domalouf/DreamCatcher/README.md

# DreamCatcher
 A react native mobile app for the DreamCatcher sleep mask

- `DreamCatcherAppNew/` - the app
- `arduino/` - mask firmware
- `hardware/` - PCB design for the mask ([details](hardware/README.md))
