domalouf/DreamCatcher/hardware/dreamcatcher-eye-sensor/drc-report.txt

** Drc report for  **
** Created on 2026-11-14 04:47:26 **

** Found 0 DRC violations **

** Found 0 unconnected pads **

** Found 0 Footprint errors **

** End of Report **
