domalouf/DreamCatcher/DreamCatcherAppNew/src/images/landscape.jpg

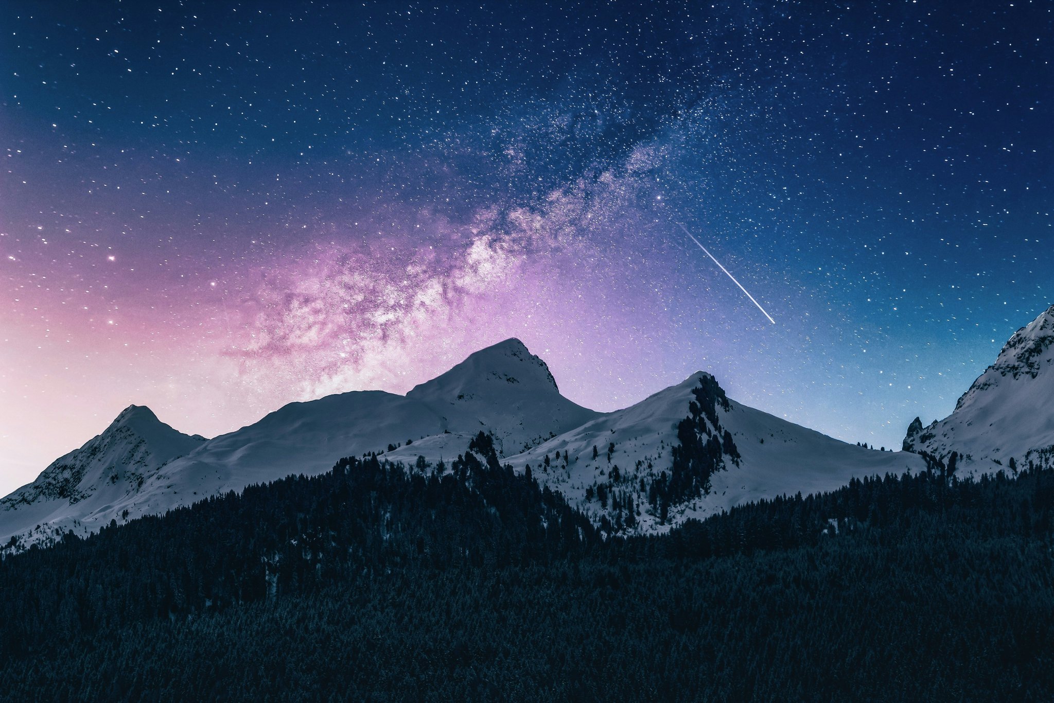
DreamCatcherAppNew/src/images/landscape.jpg
