domalouf/DreamCatcher/DreamCatcherAppNew/src/images/starBackground.jpg

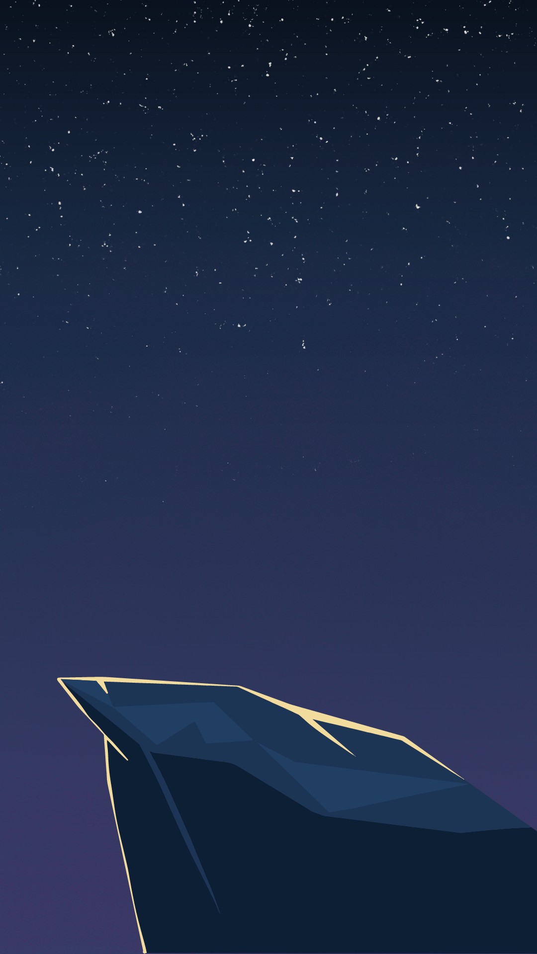
DreamCatcherAppNew/src/images/starBackground.jpg
