domalouf/DreamCatcher/DreamCatcherAppNew/src/images/UI_Inspiration1.png

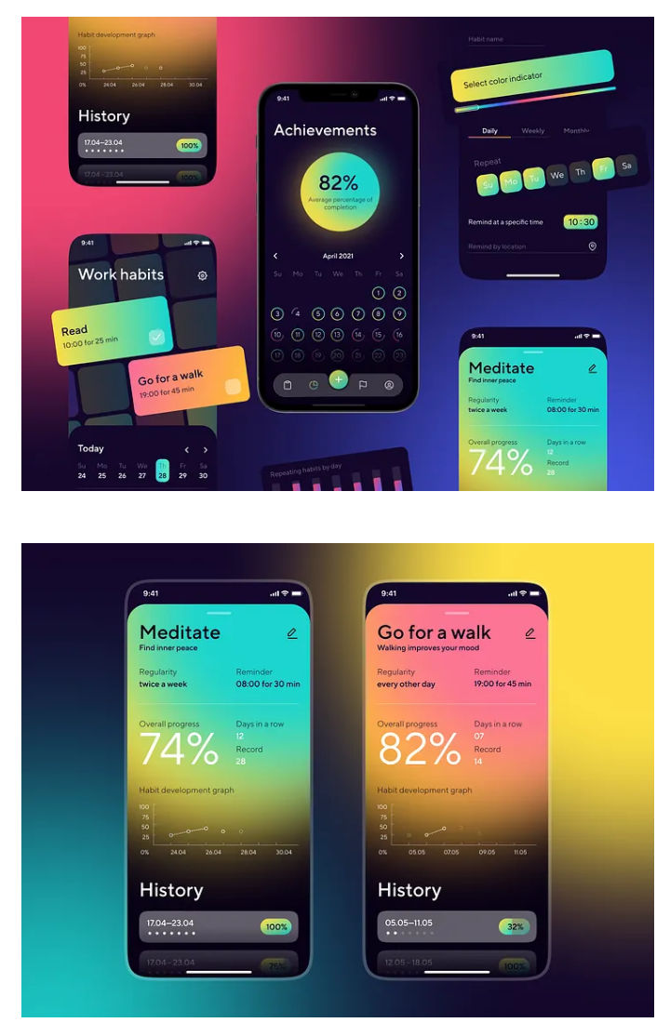
DreamCatcherAppNew/src/images/UI_Inspiration1.png
