domalouf/DreamCatcher/hardware/dreamcatcher-eye-sensor/docs/back.png

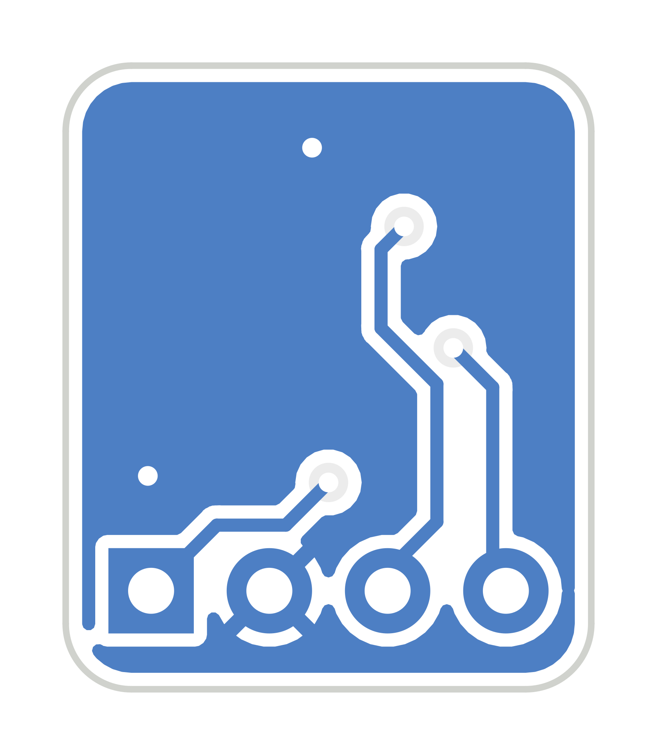
hardware/dreamcatcher-eye-sensor/docs/back.png
