domalouf/DreamCatcher/hardware/dreamcatcher-main/docs/back.png

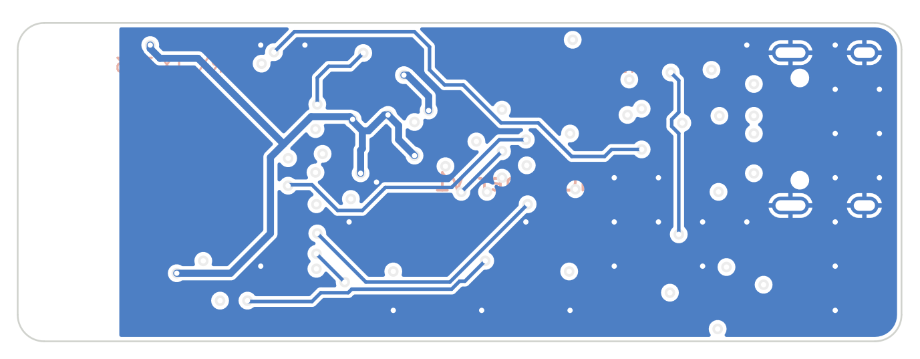
hardware/dreamcatcher-main/docs/back.png
