domalouf/DreamCatcher/hardware/dreamcatcher-main/docs/inner2.png

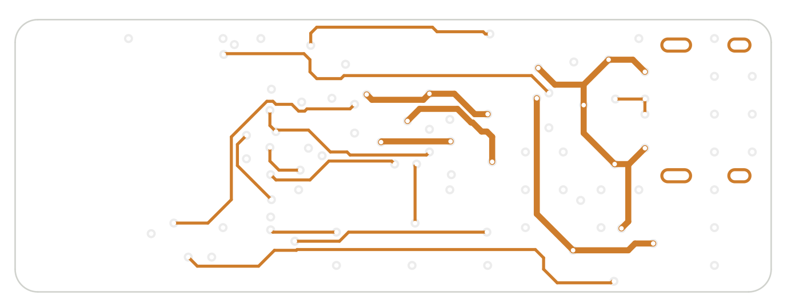
hardware/dreamcatcher-main/docs/inner2.png
