domalouf/DreamCatcher/hardware/dreamcatcher-main/fab/dreamcatcher-main-bom.csv

Comment | Designator | Footprint | MPN | LCSC Part #
4.7uF | C1,C2 | C_0603_1608Metric | 0603 4.7uF X5R/X7R | C19666
1nF | C10,C11 | C_0402_1005Metric | 0402 1nF X5R/X7R | C1523
10uF | C5,C4 | C_0603_1608Metric | 0603 10uF X5R/X7R | C19702
100nF | C6,C8,C12,C9 | C_0402_1005Metric | 0402 100nF X5R/X7R | C1525
1uF | C7,C3 | C_0402_1005Metric | 0402 1uF X5R/X7R | C52923
B5819WS | D1 | D_SOD-323 | B5819WS | C64886
RED | D2 | LED_0603_1608Metric | 0603 red LED | C2286
GREEN | D3 | LED_0603_1608Metric | 0603 green LED | C72043
USB-C | J1 | USB_C_Receptacle_HRO_TYPE-C-31-M-12 | TYPE-C-31-M-12 | C165948
EYE L | J2 | JST_SH_SM04B-SRSS-TB_1x04-1MP_P1.00mm_Horizontal | SM04B-SRSS-TB | C160404
EYE R | J3 | JST_SH_SM04B-SRSS-TB_1x04-1MP_P1.00mm_Horizontal | SM04B-SRSS-TB | C160404
AO3401A | Q1,Q2 | SOT-23 | AO3401A | C15127
5.1k | R1,R2 | R_0402_1005Metric | 0402 5.1k 1% | C25905
4.7k | R11,R12 | R_0402_1005Metric | 0402 4.7k 1% | C25900
100k | R13 | R_0402_1005Metric | 0402 100k 1% | C25741
220 | R14,R15 | R_0402_1005Metric | 0402 220 1% | C25091
47k | R16,R17 | R_0402_1005Metric | 0402 47k 1% | C25792
100 | R18,R19 | R_0402_1005Metric | 0402 100 1% | C25076
2.2k | R4 | R_0402_1005Metric | 0402 2.2k 1% | C25879
10k | R6,R3,R5 | R_0402_1005Metric | 0402 10k 1% | C25744
1M | R7,R8 | R_0402_1005Metric | 0402 1M 1% | C26083
1k | R9 | R_0402_1005Metric | 0402 1k 1% | C11702
RESET | SW1 | SW_SPST_B3U-1000P | B3U-1000P | C231329
ESP32-C3-MINI-1-N4 | U1 | ESP32-C3-MINI-1 | ESP32-C3-MINI-1-N4 | C2838502
MCP73831-2-OT | U2 | SOT-23-5 | MCP73831T-2ACI/OT | C424093
XC6220B331MR | U3 | SOT-23-5 | XC6220B331MR-G | C86534
LIS2DH12 | U4 | LGA-12_2x2mm_P0.5mm | LIS2DH12TR | C110926
USBLC6-2SC6 | U5 | SOT-23-6 | USBLC6-2SC6 | C7519
