domalouf/DreamCatcher/hardware/dreamcatcher-eye-sensor/fab/dreamcatcher-eye-sensor-bom.csv

Comment | Designator | Footprint | MPN | LCSC Part #
RED | D1 | LED_0603_1608Metric | 0603 red LED | C2286
QRE1113GR | U1 | OnSemi_CASE100CY | QRE1113GR | C232862
