domalouf/DreamCatcher/hardware/dreamcatcher-eye-sensor/docs/assembly.png

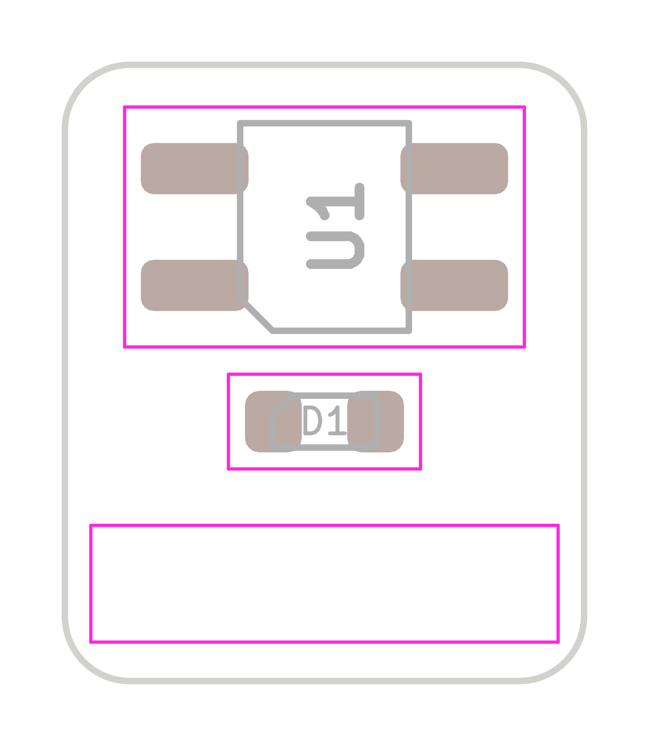
hardware/dreamcatcher-eye-sensor/docs/assembly.png
