domalouf/DreamCatcher/hardware/dreamcatcher-main/docs/assembly.png

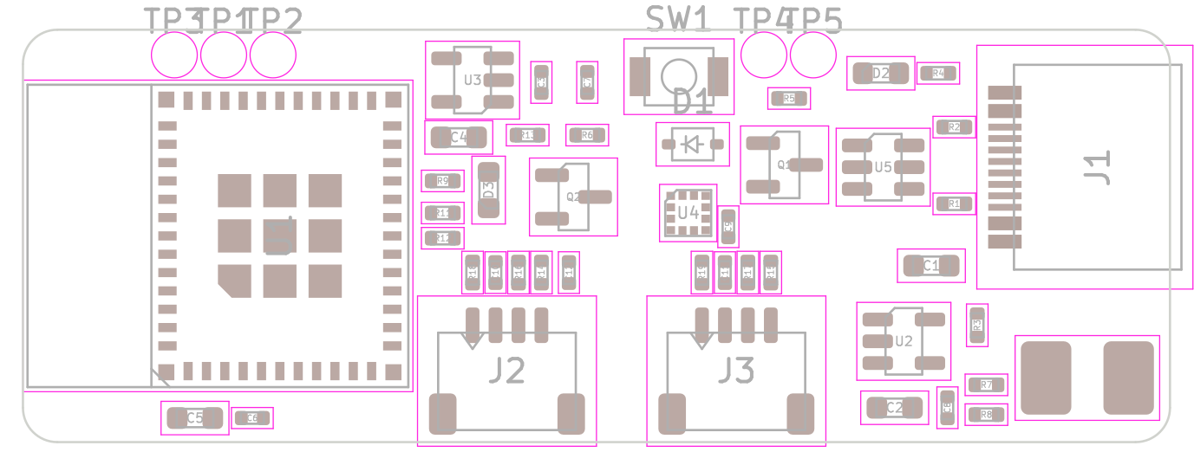
hardware/dreamcatcher-main/docs/assembly.png
