domalouf/DreamCatcher/hardware/dreamcatcher-eye-sensor/docs/schematic.pdf

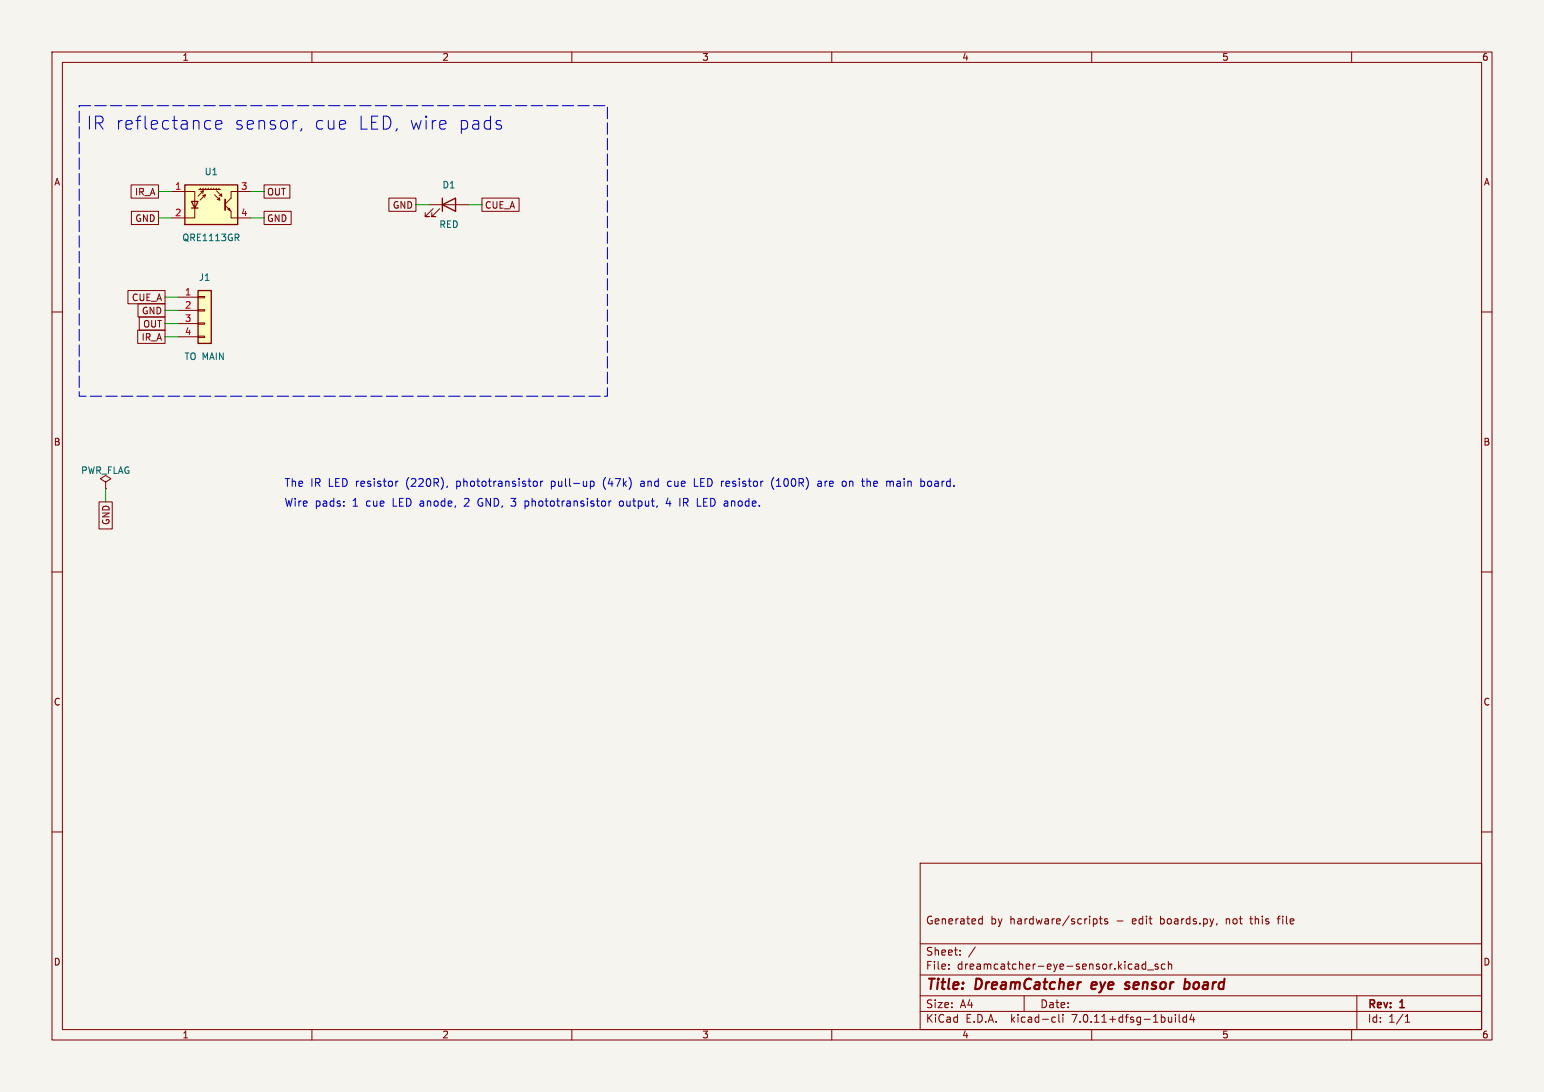
[picture p11: page 1]

Id: 1/1 Title: DreamCatcher eye sensor board
