domalouf/DreamCatcher/hardware/dreamcatcher-main/docs/schematic.pdf

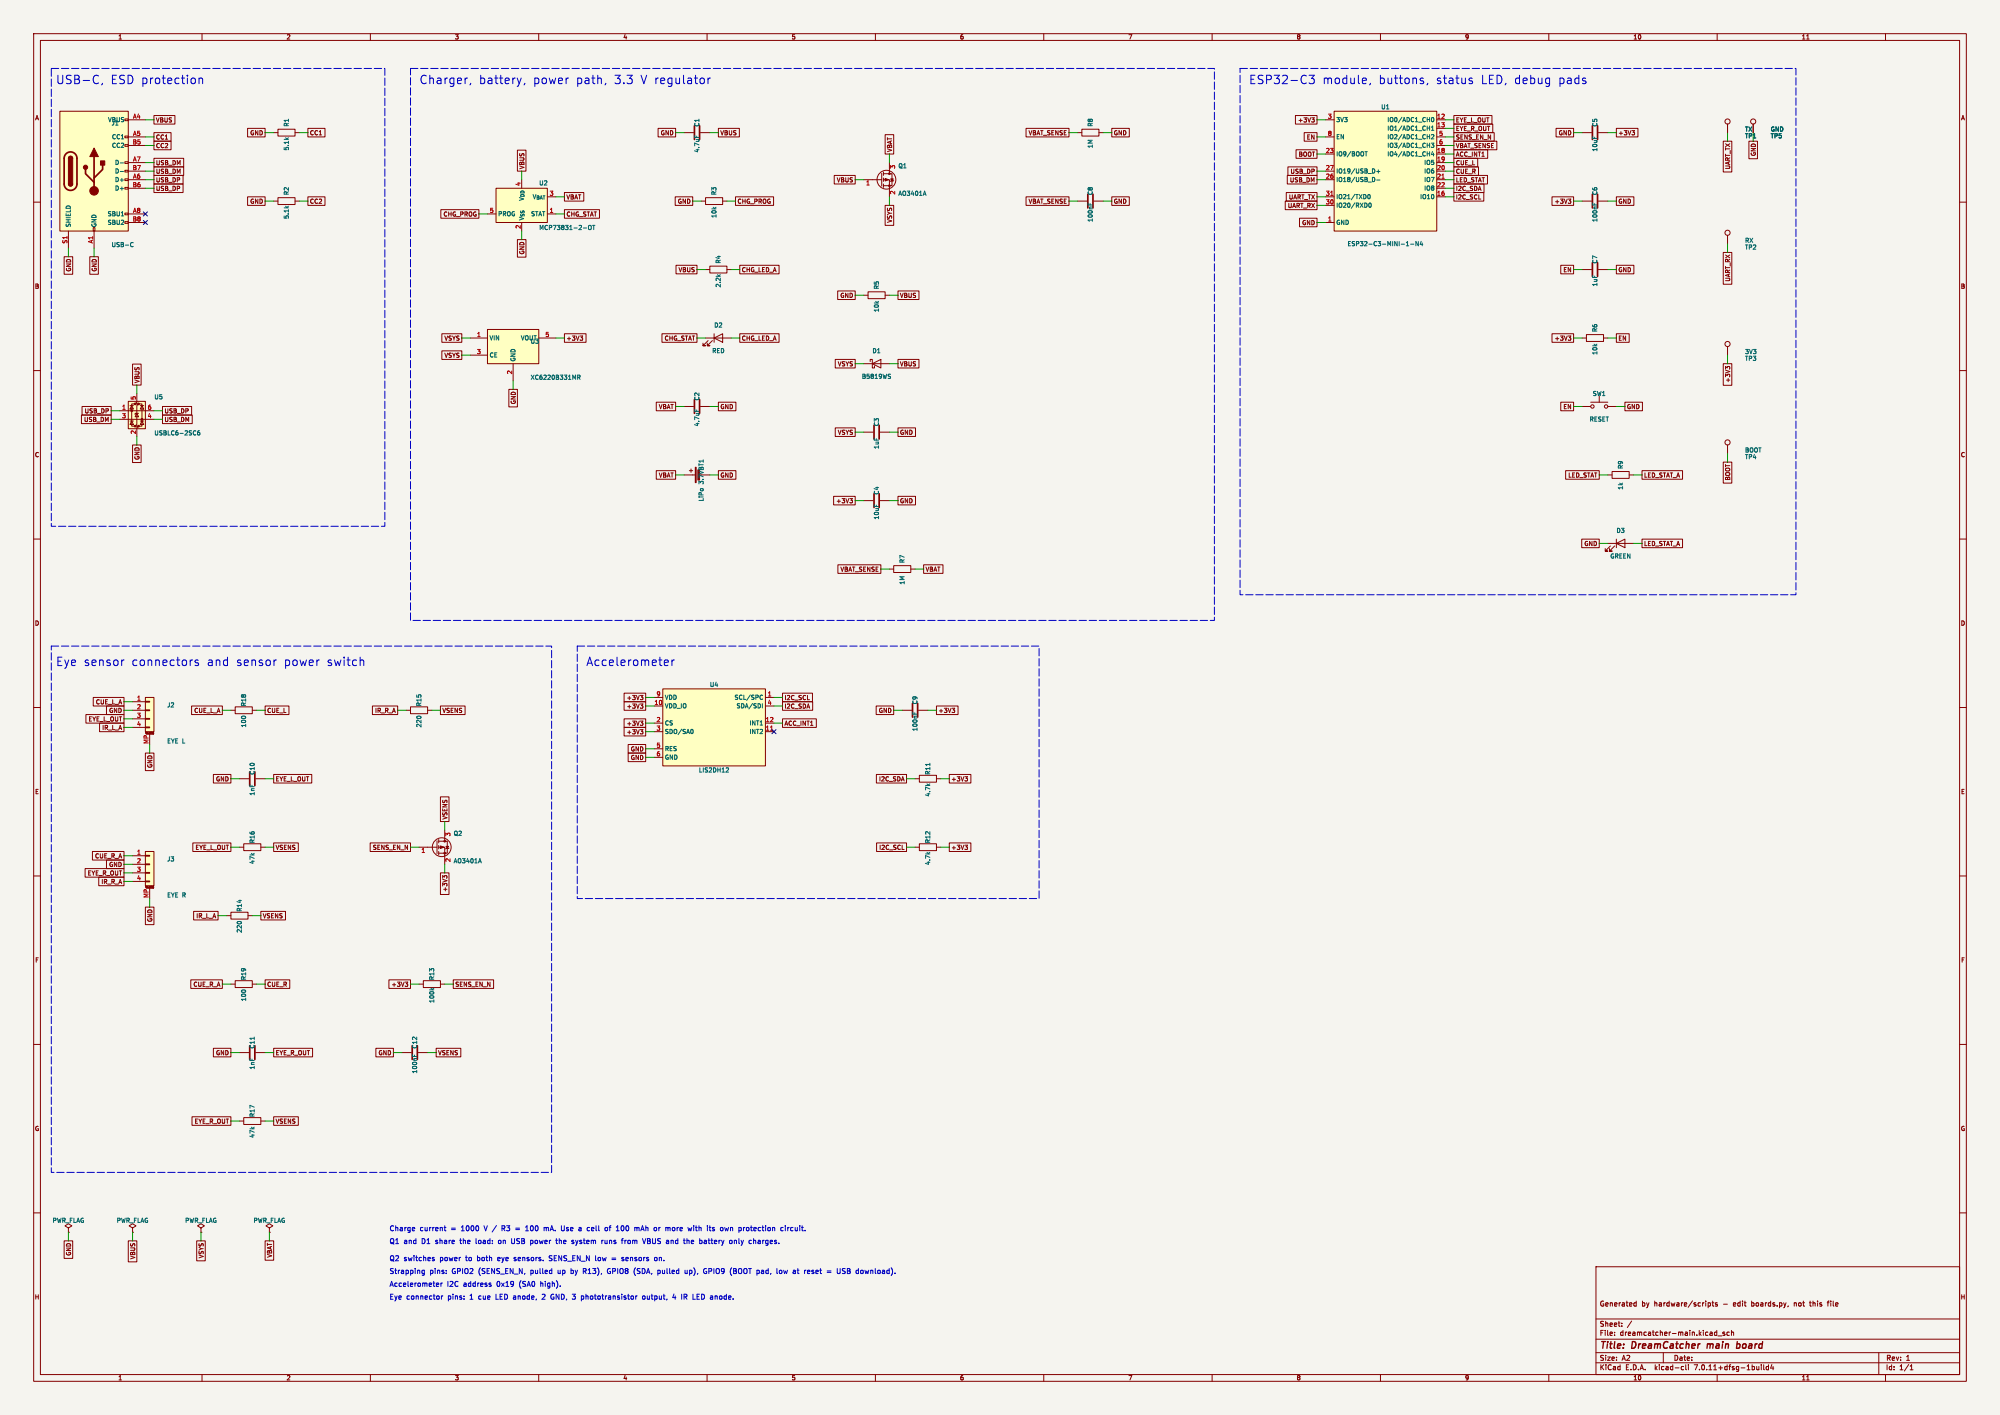
[picture p12: page 1]

Q1 and D1 share the load: on USB power the system runs from VBUS and the battery only charges.

Q2 switches power to both eye sensors. SENS_EN_N low = sensors on.
