domalouf/DreamCatcher/hardware/dreamcatcher-main/dreamcatcher-main.kicad_pcb

## KiCad design hardware/dreamcatcher-main/dreamcatcher-main.kicad_pcb (2026-11-14)

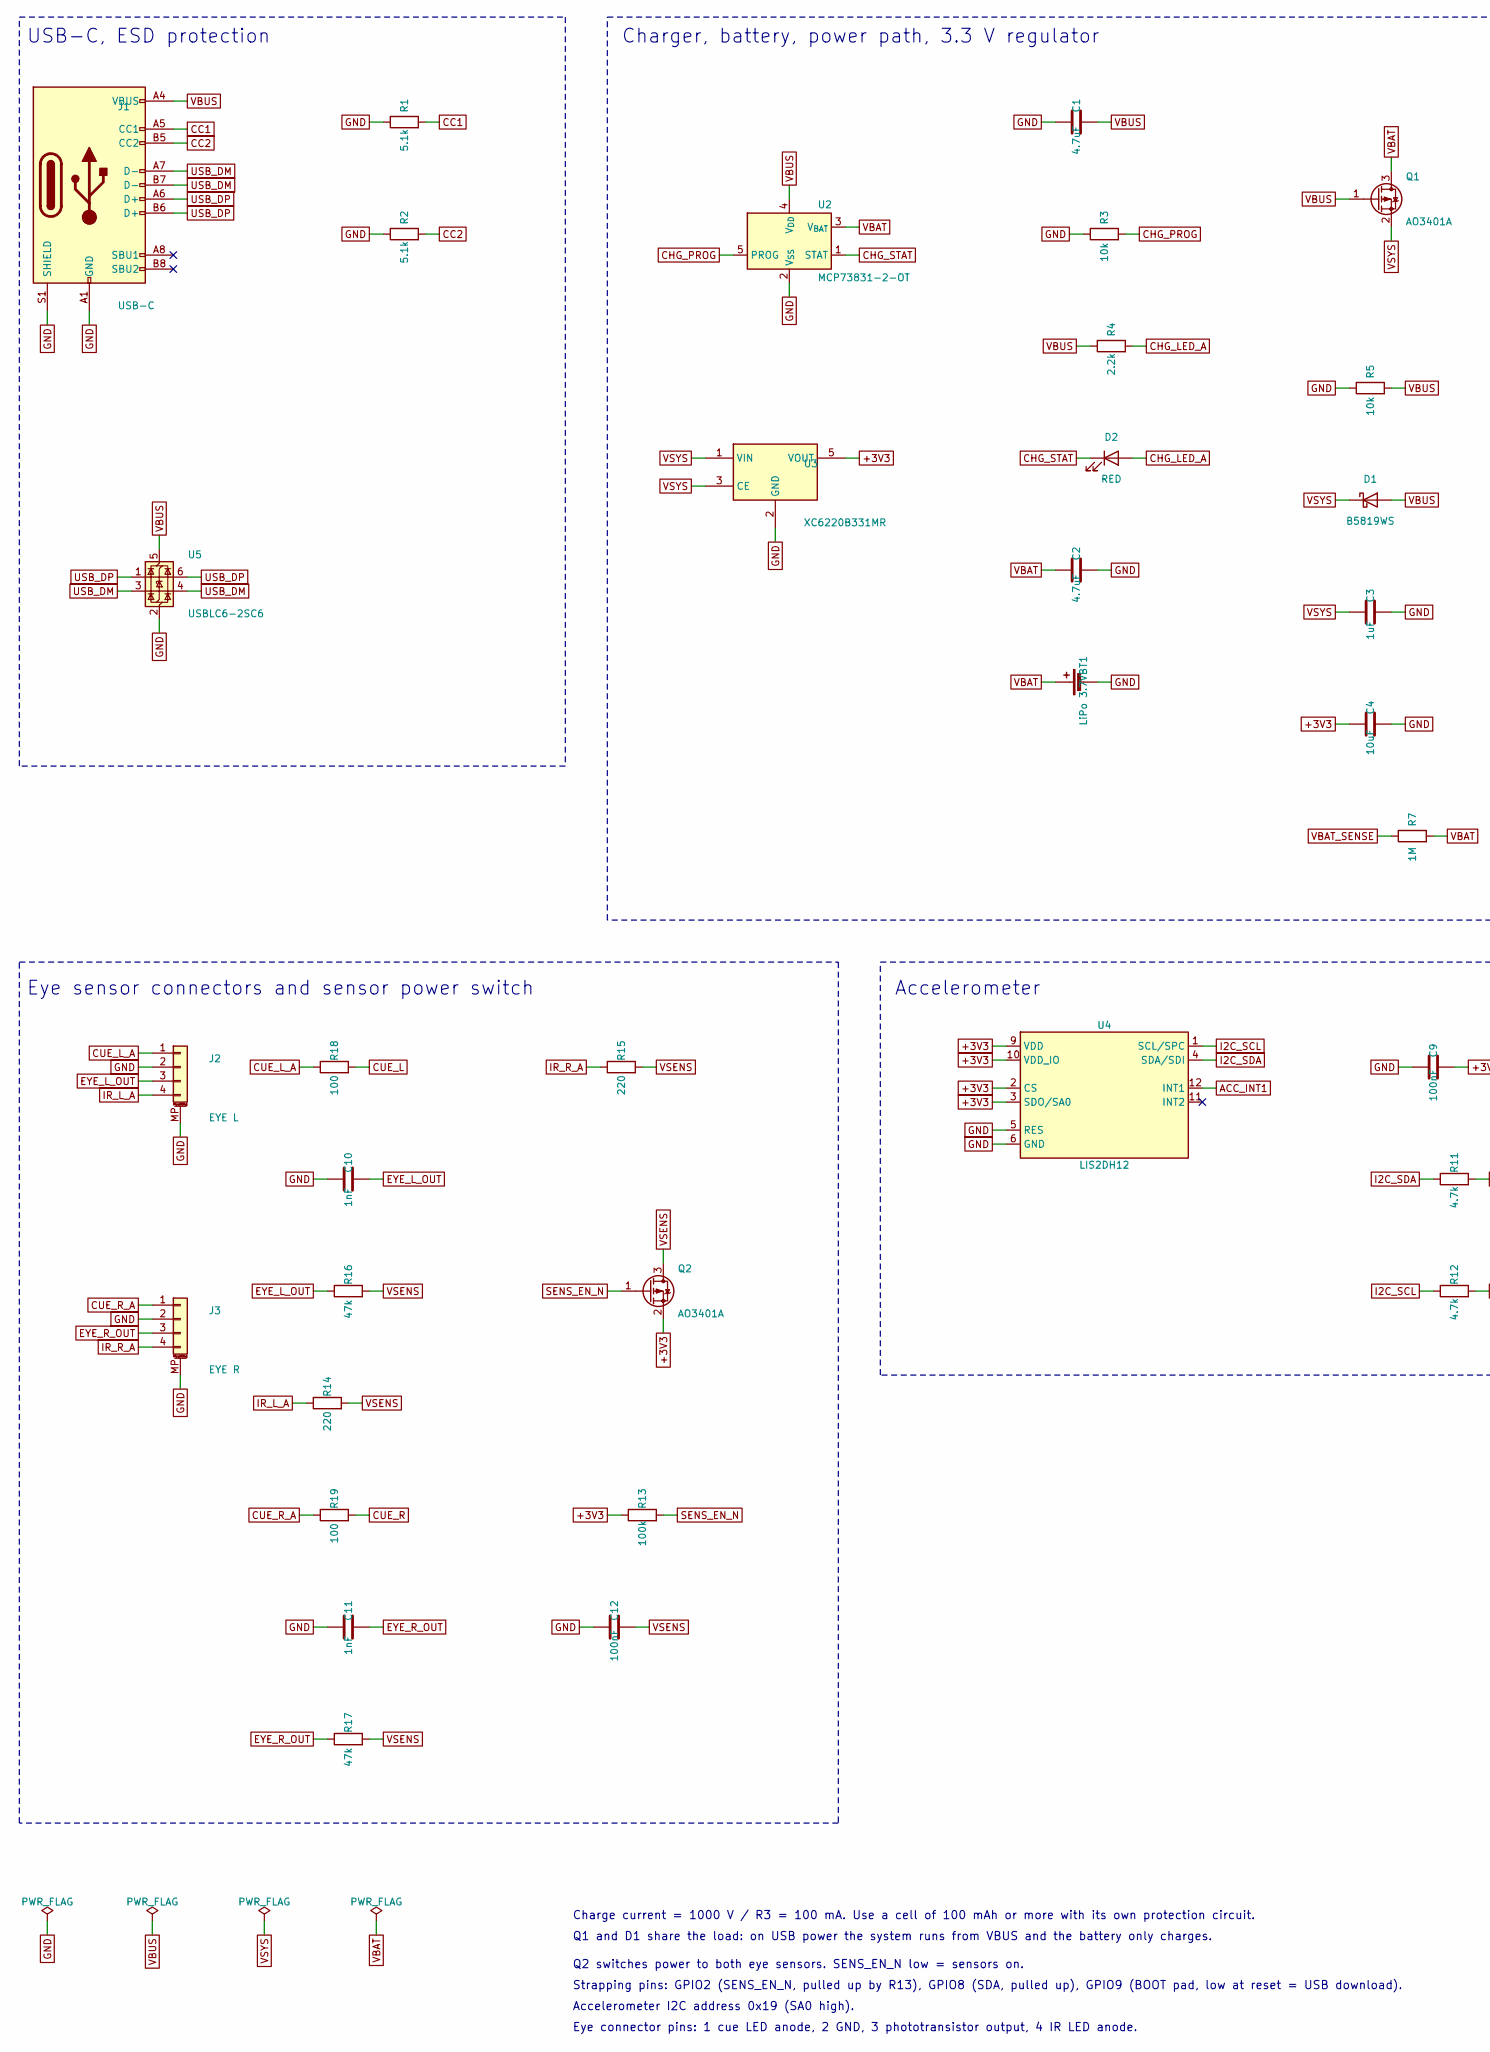
[picture p13: schematic dreamcatcher-main.kicad_sch, DreamCatcher main board, part in row 1, column 1]

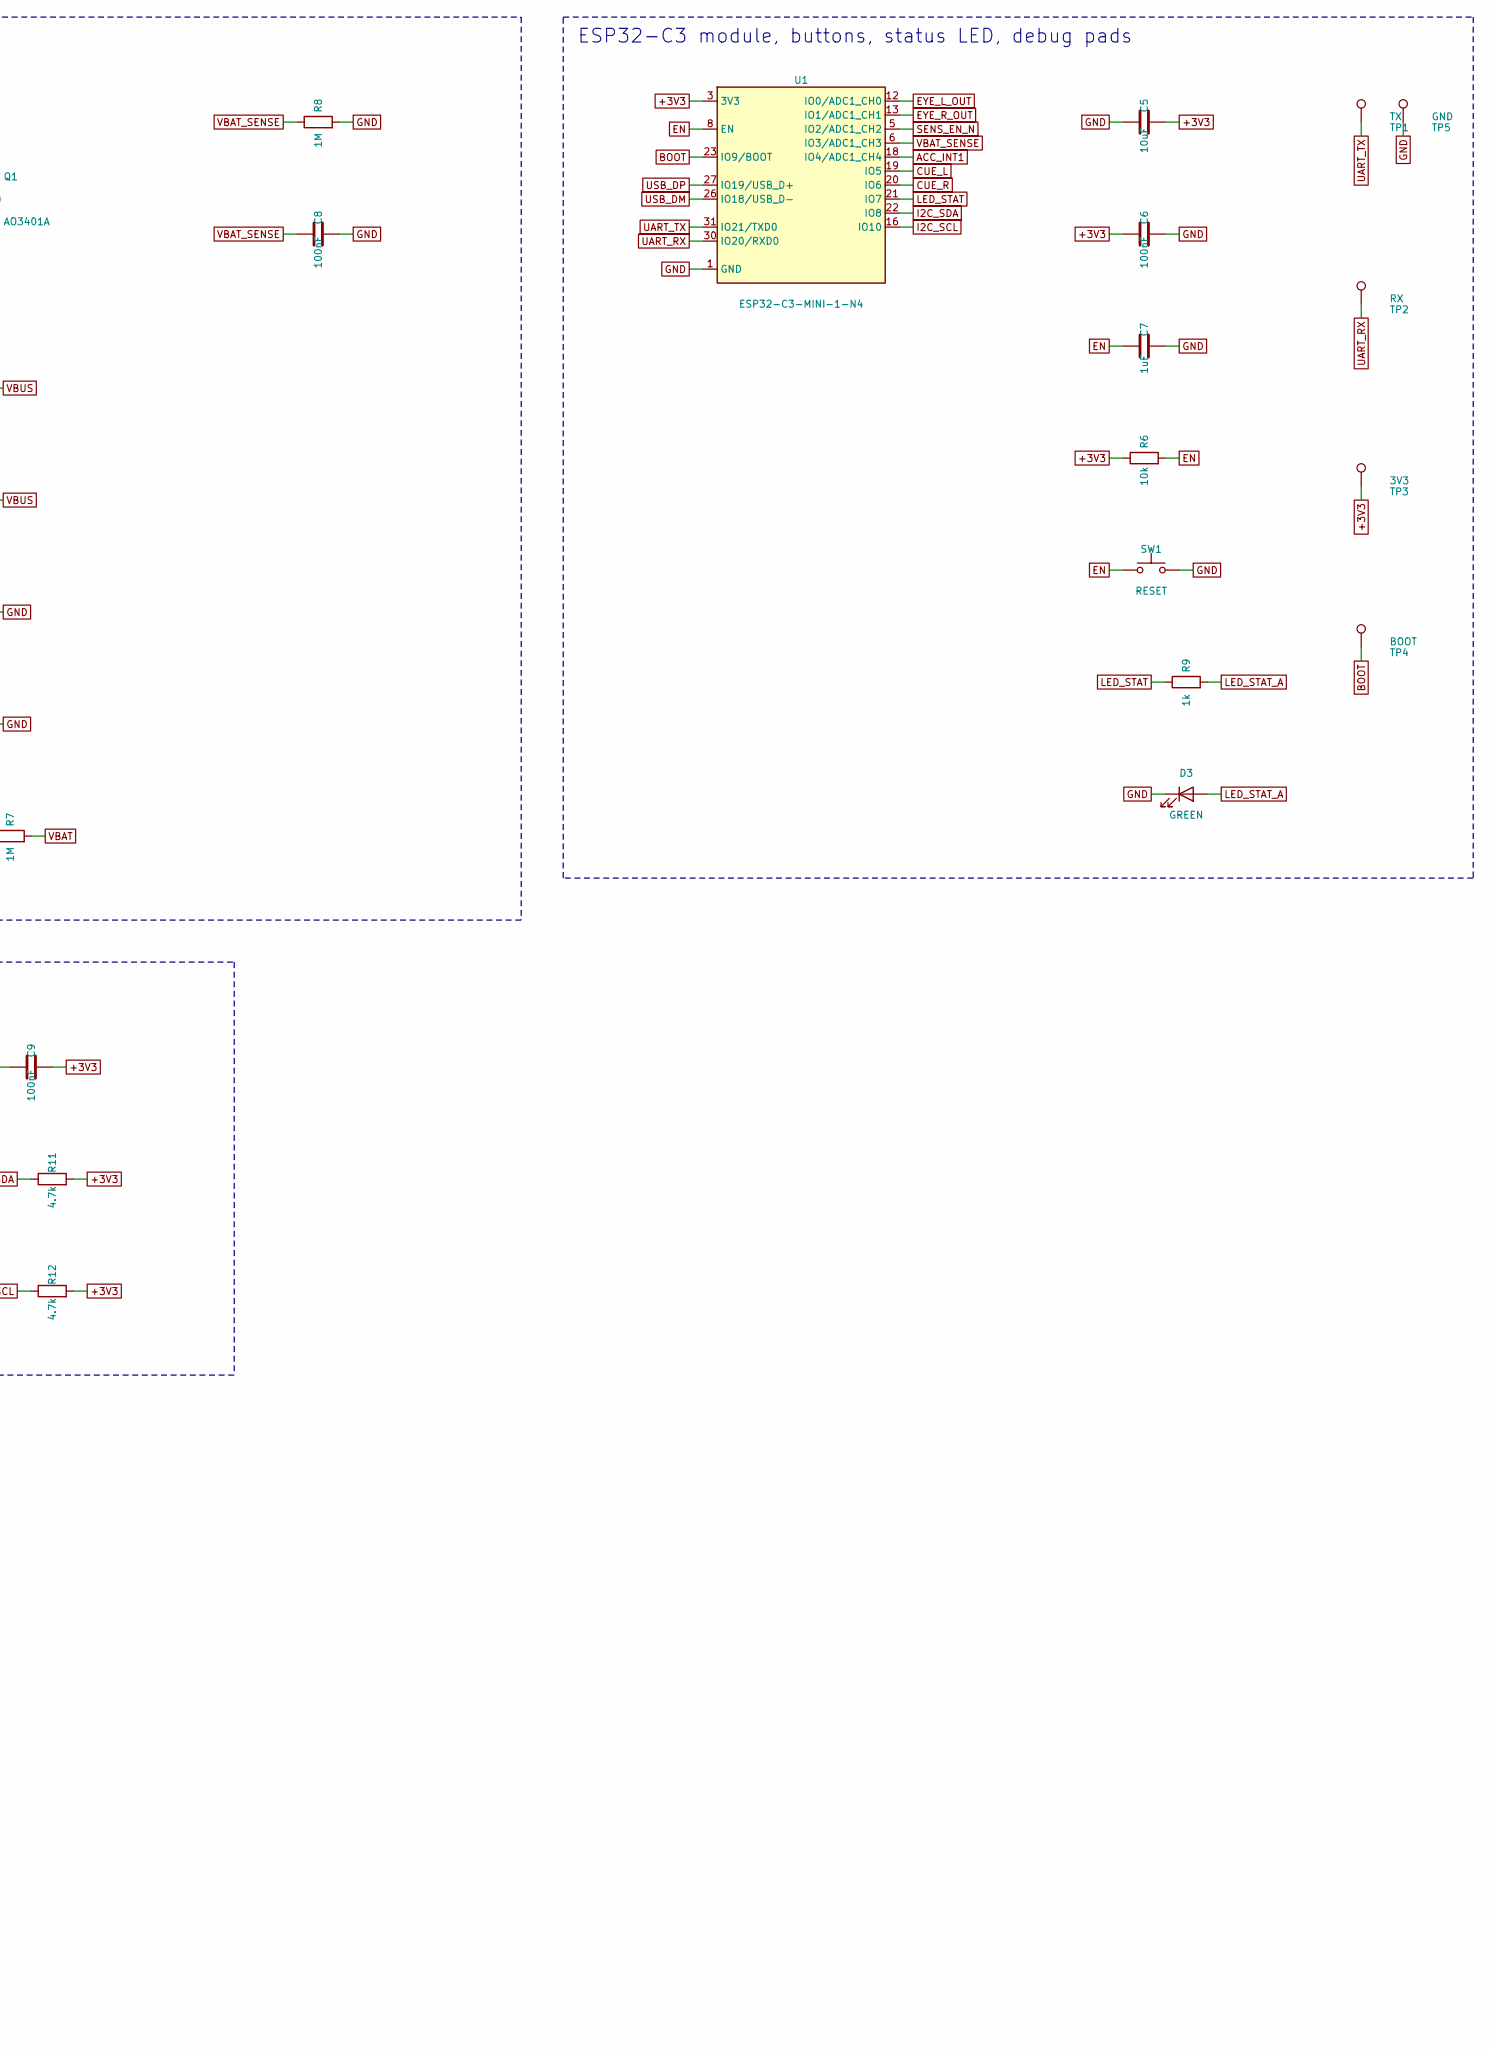
[picture p14: schematic dreamcatcher-main.kicad_sch, DreamCatcher main board, part in row 1, column 2]

Parts:
BT1: LiPo 3.7V; BatteryPads_P3.6mm
C1, C2: 4.7uF; C_0603_1608Metric; MPN 0603 4.7uF X5R/X7R; LCSC C19666
C3, C7: 1uF; C_0402_1005Metric; MPN 0402 1uF X5R/X7R; LCSC C52923
C4, C5: 10uF; C_0603_1608Metric; MPN 0603 10uF X5R/X7R; LCSC C19702
C6, C8, C9, C12: 100nF; C_0402_1005Metric; MPN 0402 100nF X5R/X7R; LCSC C1525
C10, C11: 1nF; C_0402_1005Metric; MPN 0402 1nF X5R/X7R; LCSC C1523
D1: B5819WS; D_SOD-323; MPN B5819WS; LCSC C64886
D2: RED; LED_0603_1608Metric; MPN 0603 red LED; LCSC C2286
D3: GREEN; LED_0603_1608Metric; MPN 0603 green LED; LCSC C72043
J1: USB-C; USB_C_Receptacle_HRO_TYPE-C-31-M-12; MPN TYPE-C-31-M-12; LCSC C165948
J2: EYE L; JST_SH_SM04B-SRSS-TB_1x04-1MP_P1.00mm_Horizontal; MPN SM04B-SRSS-TB; LCSC C160404
J3: EYE R; JST_SH_SM04B-SRSS-TB_1x04-1MP_P1.00mm_Horizontal; MPN SM04B-SRSS-TB; LCSC C160404
Q1, Q2: AO3401A; SOT-23; MPN AO3401A; LCSC C15127
R1, R2: 5.1k; R_0402_1005Metric; MPN 0402 5.1k 1%; LCSC C25905
R3, R5, R6: 10k; R_0402_1005Metric; MPN 0402 10k 1%; LCSC C25744
R4: 2.2k; R_0402_1005Metric; MPN 0402 2.2k 1%; LCSC C25879
R7, R8: 1M; R_0402_1005Metric; MPN 0402 1M 1%; LCSC C26083
R9: 1k; R_0402_1005Metric; MPN 0402 1k 1%; LCSC C11702
R11, R12: 4.7k; R_0402_1005Metric; MPN 0402 4.7k 1%; LCSC C25900
R13: 100k; R_0402_1005Metric; MPN 0402 100k 1%; LCSC C25741
R14, R15: 220; R_0402_1005Metric; MPN 0402 220 1%; LCSC C25091
R16, R17: 47k; R_0402_1005Metric; MPN 0402 47k 1%; LCSC C25792
R18, R19: 100; R_0402_1005Metric; MPN 0402 100 1%; LCSC C25076
SW1: RESET; SW_SPST_B3U-1000P; MPN B3U-1000P; LCSC C231329
TP1: TX; TestPoint_Pad_D1.0mm
TP2: RX; TestPoint_Pad_D1.0mm
TP3: 3V3; TestPoint_Pad_D1.0mm
TP4: BOOT; TestPoint_Pad_D1.0mm
TP5: GND; TestPoint_Pad_D1.0mm
U1: ESP32-C3-MINI-1-N4; ESP32-C3-MINI-1; MPN ESP32-C3-MINI-1-N4; LCSC C2838502
U2: MCP73831-2-OT; SOT-23-5; MPN MCP73831T-2ACI/OT; LCSC C424093
U3: XC6220B331MR; SOT-23-5; MPN XC6220B331MR-G; LCSC C86534
U4: LIS2DH12; LGA-12_2x2mm_P0.5mm; MPN LIS2DH12TR; LCSC C110926
U5: USBLC6-2SC6; SOT-23-6; MPN USBLC6-2SC6; LCSC C7519

Connections:
+3V3: C4.1, C5.2, C6.1, C9.2, Q2.2 (S), R6.1, R11.2, R12.2, R13.1, TP3.1, U1.3 (3V3), U3.5 (VOUT), U4.2 (CS), U4.3 (SDO/SA0), U4.9 (VDD), U4.10 (VDD_IO)
ACC_INT1: U1.18 (IO4/ADC1_CH4), U4.12 (INT1)
BOOT: TP4.1, U1.23 (IO9/BOOT)
CC1: J1.A5 (CC1), R1.2
CC2: J1.B5 (CC2), R2.2
CHG_LED_A: D2.2 (A), R4.2
CHG_PROG: R3.2, U2.5 (PROG)
CHG_STAT: D2.1 (K), U2.1 (STAT)
CUE_L: R18.2, U1.19 (IO5)
CUE_L_A: J2.1, R18.1
CUE_R: R19.2, U1.20 (IO6)
CUE_R_A: J3.1, R19.1
EN: C7.1, R6.2, SW1.1, U1.8 (EN)
EYE_L_OUT: C10.2, J2.3, R16.1, U1.12 (IO0/ADC1_CH0)
EYE_R_OUT: C11.2, J3.3, R17.1, U1.13 (IO1/ADC1_CH1)
GND: BT1.2 (-), C1.1, C2.2, C3.2, C4.2, C5.1, C6.2, C7.2, C8.2, C9.1, C10.1, C11.1, C12.1, D3.1 (K), J1.A1 (GND), J1.A12 (GND), J1.B1 (GND), J1.B12 (GND), J1.S1 (SHIELD), J2.2, J2.MP (MountPin), J3.2, J3.MP (MountPin), R1.1, R2.1, R3.1, R5.1, R8.2, SW1.2, TP5.1, U1.1 (GND), U1.2, U1.11, U1.14, U1.36, U1.37, U1.38, U1.39, U1.40, U1.41, U1.42, U1.43, U1.44, U1.45, U1.46, U1.47, U1.48, U1.49, U1.50, U1.51, U1.52, U1.53, U2.2 (V_{SS}), U3.2 (GND), U4.5 (RES), U4.6 (GND), U4.7, U4.8, U5.2 (GND)
I2C_SCL: R12.1, U1.16 (IO10), U4.1 (SCL/SPC)
I2C_SDA: R11.1, U1.22 (IO8), U4.4 (SDA/SDI)
IR_L_A: J2.4, R14.1
IR_R_A: J3.4, R15.1
LED_STAT: R9.1, U1.21 (IO7)
LED_STAT_A: D3.2 (A), R9.2
SENS_EN_N: Q2.1 (G), R13.2, U1.5 (IO2/ADC1_CH2)
UART_RX: TP2.1, U1.30 (IO20/RXD0)
UART_TX: TP1.1, U1.31 (IO21/TXD0)
USB_DM: J1.A7 (D-), J1.B7 (D-), U1.26 (IO18/USB_D-), U5.3 (I/O2), U5.4 (I/O2)
USB_DP: J1.A6 (D+), J1.B6 (D+), U1.27 (IO19/USB_D+), U5.1 (I/O1), U5.6 (I/O1)
VBAT: BT1.1 (+), C2.1, Q1.3 (D), R7.2, U2.3 (V_{BAT})
VBAT_SENSE: C8.1, R7.1, R8.1, U1.6 (IO3/ADC1_CH3)
VBUS: C1.2, D1.2 (A), J1.A4 (VBUS), J1.A9 (VBUS), J1.B4 (VBUS), J1.B9 (VBUS), Q1.1 (G), R4.1, R5.2, U2.4 (V_{DD}), U5.5 (VBUS)
VSENS: C12.2, Q2.3 (D), R14.2, R15.2, R16.2, R17.2
VSYS: C3.1, D1.1 (K), Q1.2 (S), U3.1 (VIN), U3.3 (CE)

Notes on the sheet:
USB-C, ESD protection
Charger, battery, power path, 3.3 V regulator
ESP32-C3 module, buttons, status LED, debug pads
Eye sensor connectors and sensor power switch
Accelerometer
Charge current = 1000 V / R3 = 100 mA. Use a cell of 100 mAh or more with its own protection circuit.
Q1 and D1 share the load: on USB power the system runs from VBUS and the battery only charges.
Q2 switches power to both eye sensors. SENS_EN_N low = sensors on.
Strapping pins: GPIO2 (SENS_EN_N, pulled up by R13), GPIO8 (SDA, pulled up), GPIO9 (BOOT pad, low at reset = USB download).
Accelerometer I2C address 0x19 (SA0 high).
Eye connector pins: 1 cue LED anode, 2 GND, 3 phototransistor output, 4 IR LED anode.

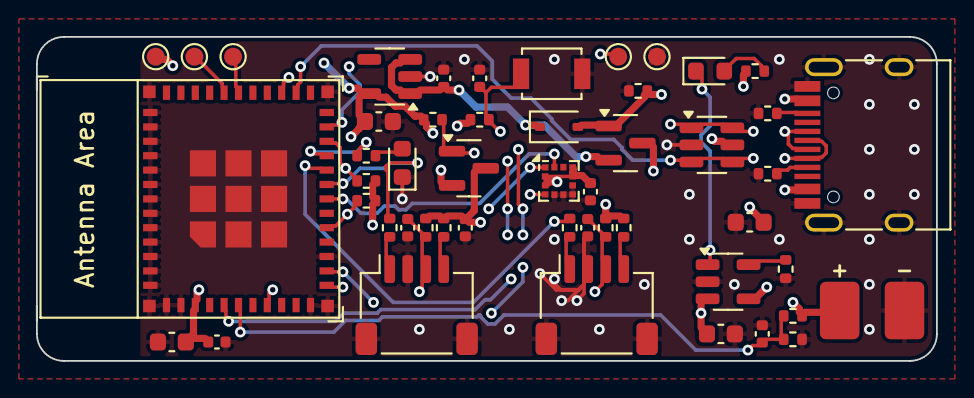
[picture p15: board dreamcatcher-main.kicad_pcb from above]

Board: 4 copper layers, 50.0 x 18.0 mm, 50 parts (0 on the bottom side), 32 nets.
