domalouf/DreamCatcher/hardware/dreamcatcher-eye-sensor/dreamcatcher-eye-sensor.kicad_pcb

## KiCad design hardware/dreamcatcher-eye-sensor/dreamcatcher-eye-sensor.kicad_pcb (2026-11-14)

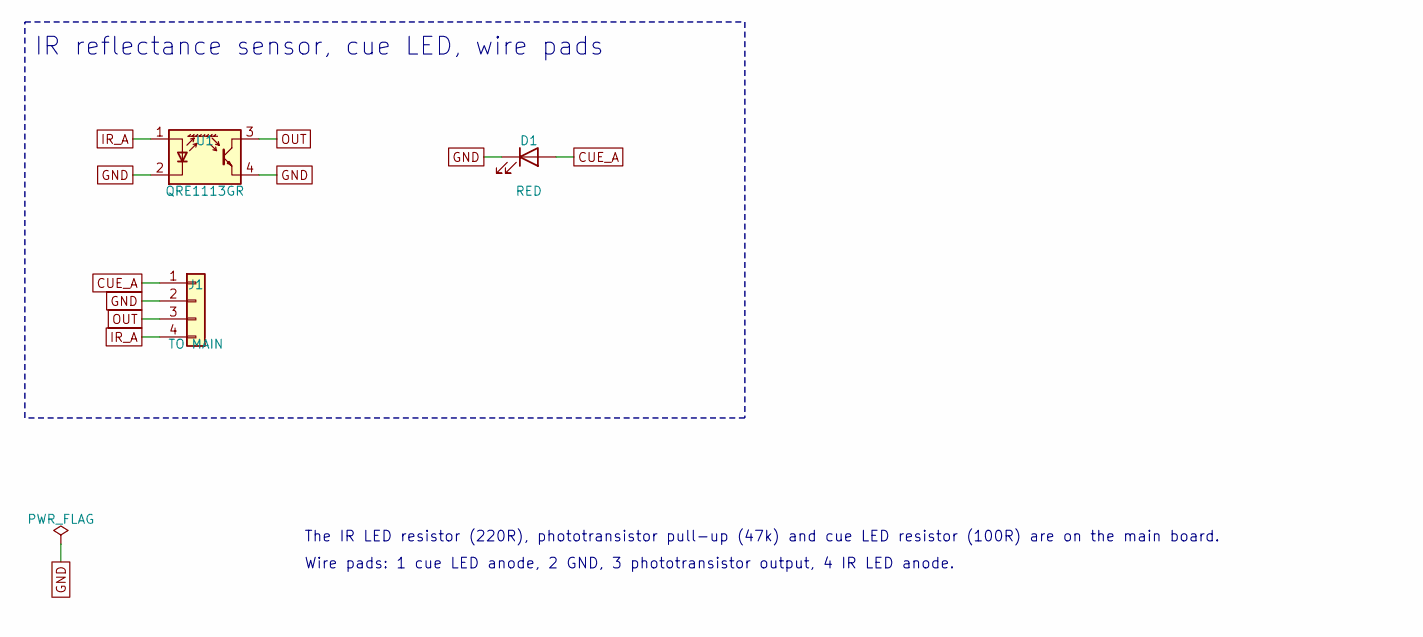
[picture p16: schematic dreamcatcher-eye-sensor.kicad_sch, DreamCatcher eye sensor board]

Parts:
D1: RED; LED_0603_1608Metric; MPN 0603 red LED; LCSC C2286
J1: TO MAIN; WirePads_1x04_P1.8mm
U1: QRE1113GR; OnSemi_CASE100CY; MPN QRE1113GR; LCSC C82486

Connections:
CUE_A: D1.2 (A), J1.1
GND: D1.1 (K), J1.2, U1.2 (K), U1.4
IR_A: J1.4, U1.1 (A)
OUT: J1.3, U1.3

Notes on the sheet:
IR reflectance sensor, cue LED, wire pads
The IR LED resistor (220R), phototransistor pull-up (47k) and cue LED resistor (100R) are on the main board.
Wire pads: 1 cue LED anode, 2 GND, 3 phototransistor output, 4 IR LED anode.

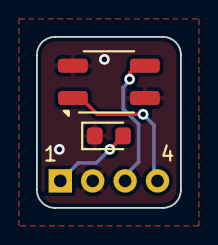
[picture p17: board dreamcatcher-eye-sensor.kicad_pcb from above]

Board: 2 copper layers, 8.0 x 9.5 mm, 3 parts (0 on the bottom side), 4 nets.
