domalouf/DreamCatcher/(commit log)

2024-04-20 Changing esp32 communication
2024-04-22 Switched icons back, I think this is a working state
2026-01-02 Added old arduino files
    Some of these might still work hopefully, probably not
2026-01-04 Adding bluetooth to app
    Trying to blend esp32 and app together harmoninousoloy
2026-01-04 got ESP32 to show up on bluetooth scan
    we are so back
2026-01-07 Consolidated connect screen
    The connect screen does everything the old DC screen did, the UI to control the esp32 pops up after the connection is made
2026-01-13 Moved arduino files
2026-01-15 Added esp32 storage check
    Basic program to check storage and ram of esp32
2026-01-19 Added IR sensor function to app
    The mobile app can trigger an IR sensing session
2026-01-19 Started sending from esp32
    The mobile app receives small data from esp32, now I need to show the IR scanning data
2026-01-19 Added real time data transfer
    The IR sensor works in real-time
2026-09-24 Clean up app screens and fix overnight time windows
    ConnectScreen:
    - Register BLE listeners, start BleManager and request permissions once on
    mount. The effect depended on isCollectingQTR, so every QTR collection
    start/end tore down and re-created all listeners and re-ran the permission
    flow. The flag is now a ref, since only the notification handler reads it.
    - Move the IR graph, time pickers and status list out of nested components
    defined during render. React treated them as new component types on every
    render, so the chart was unmounted and rebuilt for each incoming data point.
    - Resolve picked start/end times to their next occurrence. The picker keeps
    the date it was opened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
2026-09-24 Get Jest running and add ConnectScreen tests
    The template App test failed before running because Jest wasn't
    transforming the ESM navigation/icon packages and native modules weren't
    mocked. Add those, plus tests covering the BLE connect flow, QTR data
    streaming (listeners registered once, chart mounted once) and time windows
    that cross midnight.
    Claude-Session: https://claude.ai/code/session_01PLjj7PMBWG885ezLeBRxPY
2026-09-24 Add v3 firmware: on-mask REM detection with adaptive dream cues
    The v2.2 sketch blinked every 2 minutes from the start of the window until
    reset: dreamTime and dreamWindow weren't kept in RTC memory, so the window
    end was never enforced and the eye sensor wasn't used at night.
    v3 watches for REM during the window instead:
    - Reads the QTR-1A 25 times a second, powering it only while reading and
    light sleeping in between, with the CPU at 80 MHz (a few mA instead of
    ~40 mA awake).
    - Classifies sharp changes against a continuously learned noise level as
    eye movements, and large or long ones (or a saturated sensor) as body
    movements.
    - Calls the last minute REM when it has enough eye mov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
    [DreamCatcher_v3.ino, DreamLogic.h]
2026-09-24 Add sensor test, cue settings and night report to the app
    - Sensor Test: live eye sensor graph with detected eye/body movements
    marked, eye movements in the last minute, and a warning when the sensor
    can't see the eye. Readings are batched into the graph 5 times a second.
    - Dream Cue: cue brightness and REM sensitivity steppers stored on the
    mask, plus a preview flash.
    - Last Night: downloads the mask's night log automatically after
    connecting, and shows REM periods, cues and how you reacted, with a chart
    of eye movements per 5 minutes. Reports are kept on the phone.
    - Sends the phone's clock with the time window so the log has real times.
    Message parsing lives in src/ble/maskProt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
2026-11-14 WIP: hardware generator scripts for the mask PCBs
    Claude-Session: https://claude.ai/code/session_01SD2w2ipdBV7s8yiMu5nnmK
2026-11-14 WIP: both boards route cleanly
    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
2026-11-14 Add PCB design for the mask: ESP32-C3 main board and eye sensor board
    A 50 x 18 mm four-layer main board (ESP32-C3-MINI-1, USB-C charging and
    flashing, LiPo charger with power path, 3.3 V regulator, LIS2DH12
    accelerometer, two eye sensor connectors) and an 8 x 9.5 mm eye sensor
    board (QRE1113 and cue LED), as KiCad projects with JLCPCB fabrication
    files.
    The KiCad files are generated from hardware/scripts/boards.py; build.py
    routes the boards, runs KiCad's design rule check and compares the
    schematic's netlist with the board.
    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
2026-11-14 Add tests for the PCB design and fix the faults they found
    Tests read the generated KiCad and factory files and check the circuit
    (supplies, strapping pins, USB, ADC pins, charge and LED currents), the
    layout (antenna clearance, connector access, decoupling, ground plane,
    factory limits), the factory files and the track router.
    Fixed: the ground plane ran under the antenna on the inner layer, the
    regulator and USB protection chip had no ground via near their ground
    pins, and vias could sit within 0.05 mm of a solder pad.
    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
